adafruit/Adafruit-Mini-Sparkle-Motion-PCB/factory-reset/README.md

## Factory Reset file - Mini Sparkle Motion - WLED-friendly ESP32 NeoPixel LED Driver

This is the factory reset file for the Mini Sparkle Motion - WLED-friendly ESP32 NeoPixel LED Driver.
