adafruit/Adafruit-Mini-Sparkle-Motion-PCB/Adafruit Mini Sparkle Motion.brd

## EAGLE design Adafruit Mini Sparkle Motion.brd (2025-01-15)

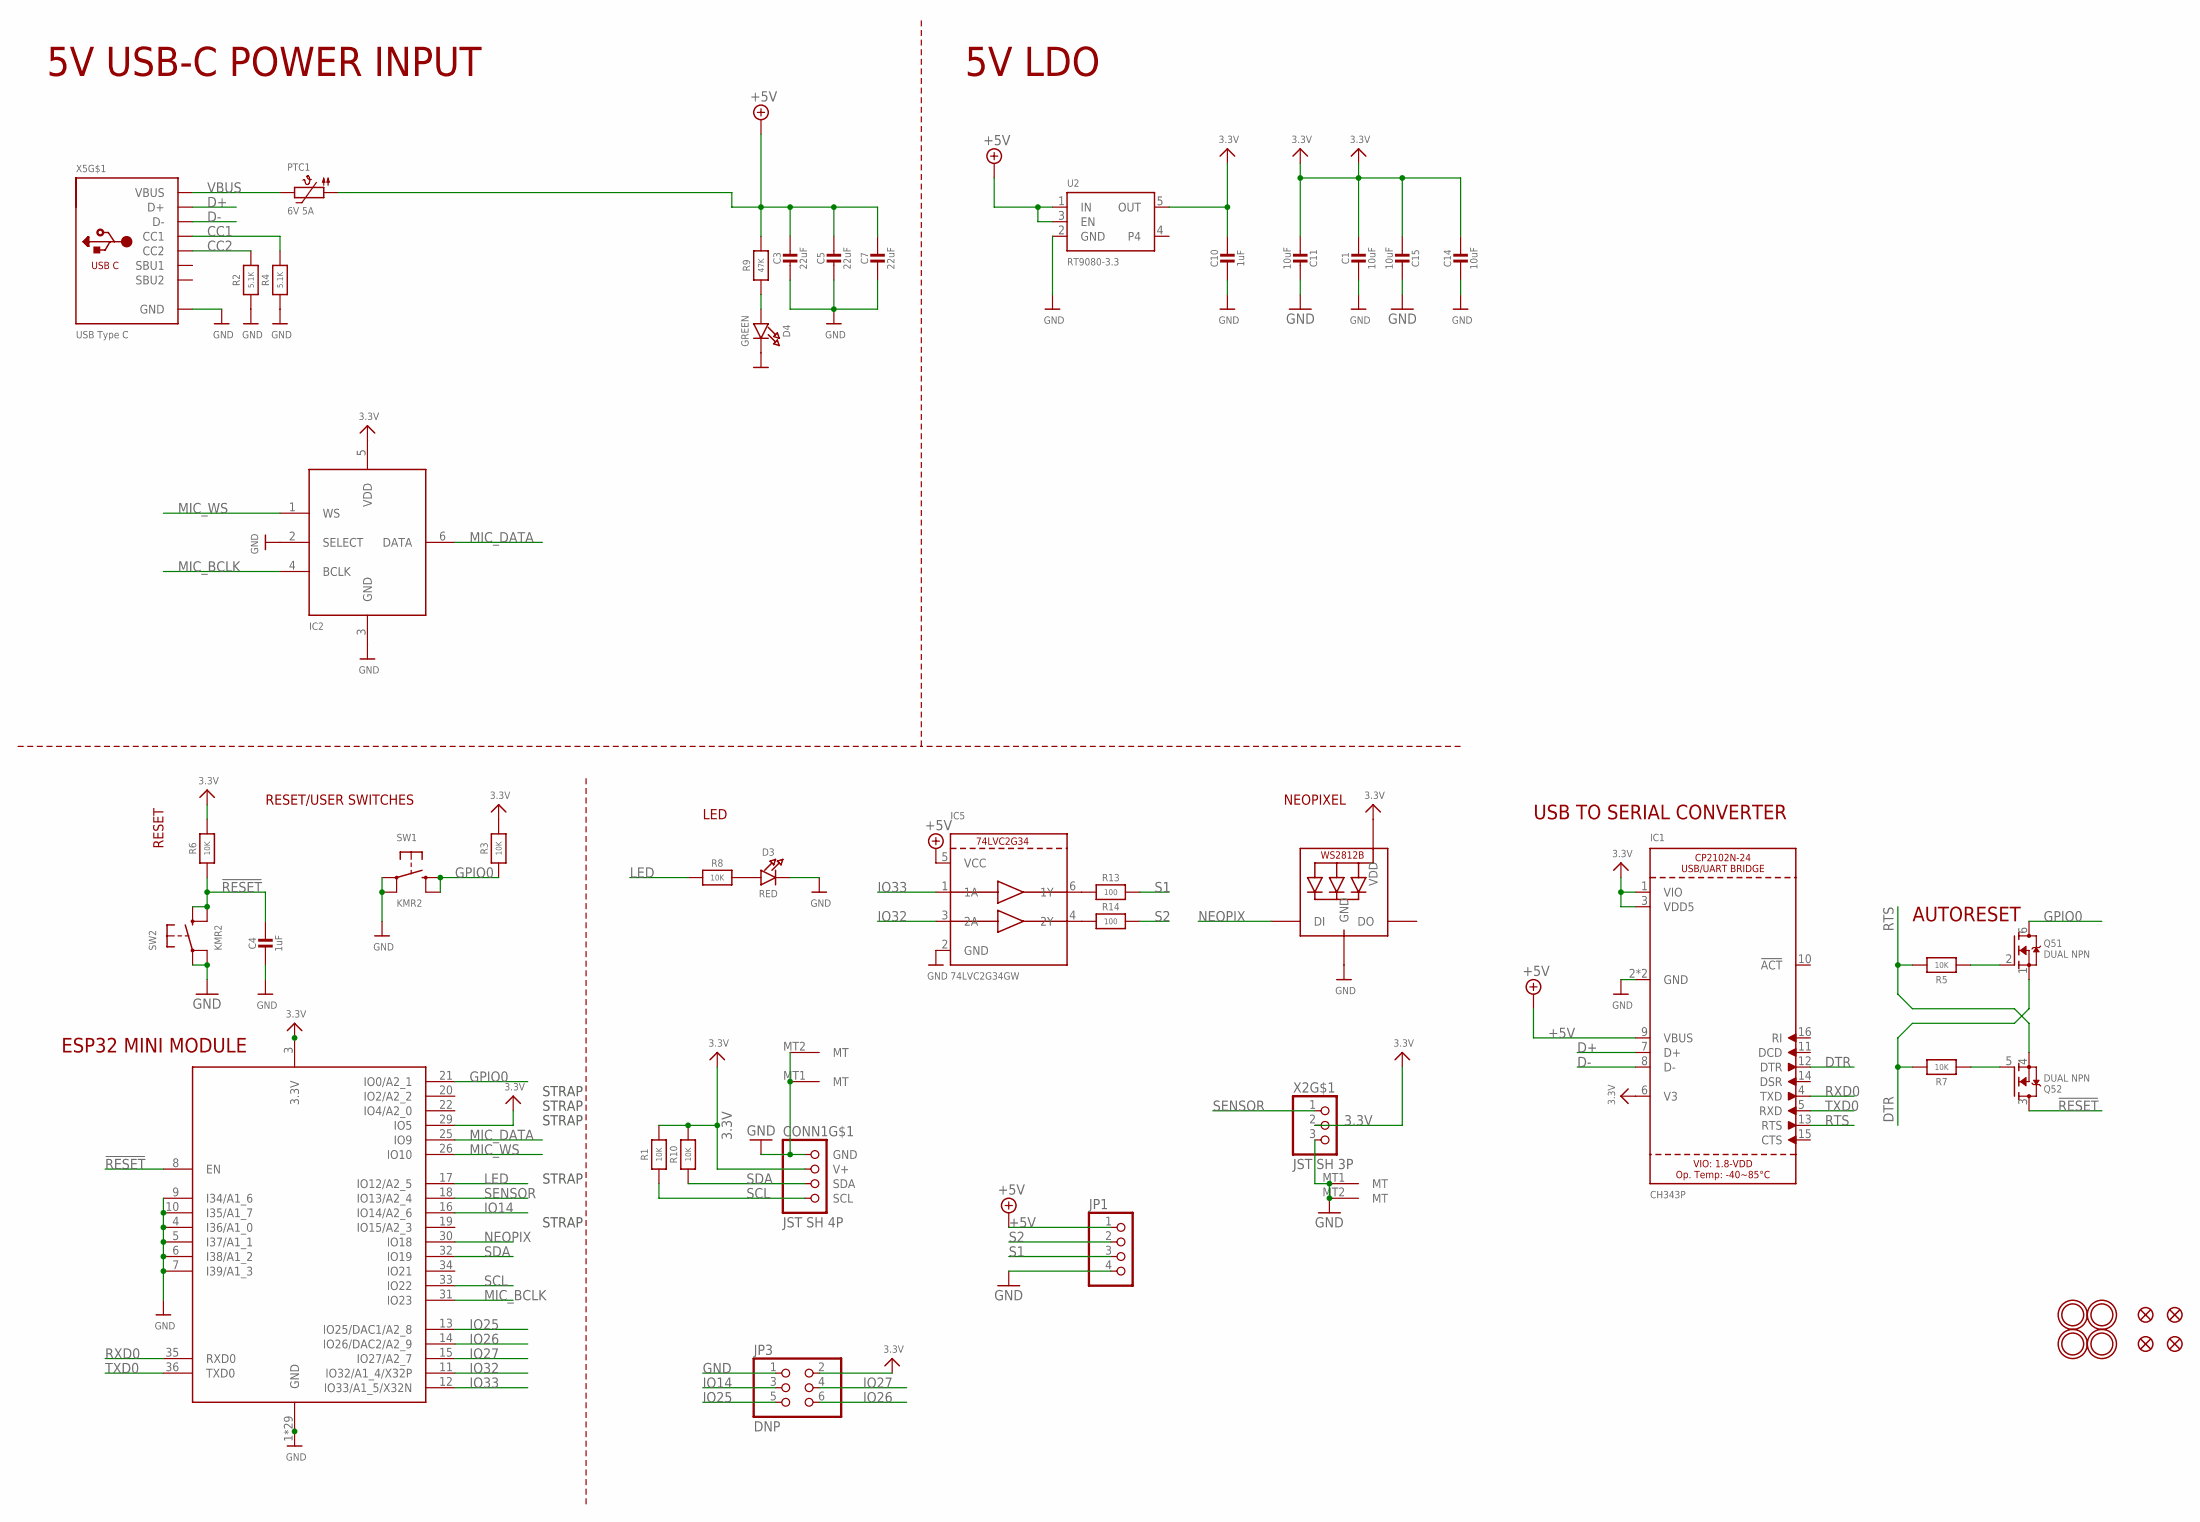
[picture p2: schematic Adafruit Mini Sparkle Motion.sch]

Parts:
C1, C11, C14, C15: 10uF; 0805-NO
C3, C5, C7: 22uF; 0805-NO
C4, C10: 1uF; _0402NO
CONN1: JST SH 4P; JST_SH4
D3: RED; CHIPLED_0603_NOOUTLINE
D4: GREEN; CHIPLED_0603_NOOUTLINE
IC1: CH343P; QFN16_3MM
IC2: ICS-43434; SPH0645LM4H
IC5: 74LVC2G34GW; SC70-6L
JP1: HEADER-1X4; 1X04_OVAL
JP3: DNP; 2X03_ROUND_70MIL
LED1: WS2812B_SK6805_1515; SK6805_1515
PTC1: 6V 5A; PTC1210
Q5: DUAL NPN; SOT363; JLC_ROTATION 90
R1, R3, R5, R6, R7, R8, R10: 10K; _0402NO
R2, R4: 5.1K; _0402NO
R9: 47K; _0402NO
R13, R14: 100; _0402NO
SW1, SW2: KMR2; BTN_RKB2_4.6X2.8
U2: RT9080-3.3; SOT23-5; JLC_ROTATION 0
U$14, U$20, U$28, U$31: MOUNTINGHOLE2.5; MOUNTINGHOLE_2.5_PLATED
U$23, U$25, U$34, U$35: FIDUCIAL_0.5MM
X2: JST SH 3P; JST_SH3
X4: ESP32-MINI-1
X5: USB Type C; USB_C_CUSB31-CFM2AX-01-X

Connections:
3.3V: C1.1, C10.1, C11.1, C14.1, C15.1, CONN1.2 (V+), IC1.1 (VIO), IC1.3 (VDD5), IC1.6 (V3), IC2.5 (VDD), JP3.2, LED1.2 (VDD), R1.2, R3.2, R6.2, R10.2, U2.5 (OUT), X2.2, X4.3 (3.3V), X4.29 (IO5)
!RESET: C4.1, Q5.3 (D), R6.1, SW2.B (S), SW2.B' (S1), X4.8 (EN)
+5V: C3.1, C5.1, C7.1, IC1.9 (VBUS), IC5.5 (VCC), JP1.1, PTC1.P$1 (1), R9.2, U2.1 (IN), U2.3 (EN)
CC1: R4.2, X5.A5 (CC1)
CC2: R2.2, X5.B5 (CC2)
D+: IC1.7 (D+), X5.A6 (D+), X5.B6 (D+)
D-: IC1.8 (D-), X5.A7 (D-), X5.B7 (D-)
DTR: IC1.12 (DTR), Q5.1 (S), R7.2
GND: C1.2, C3.2, C4.2, C5.2, C7.2, C10.2, C11.2, C14.2, C15.2, CONN1.1 (GND), CONN1.MT1 (MT), CONN1.MT2 (MT), D3.C, D4.C, IC1.2 (GND), IC1.THERMAL (GND), IC2.2 (SELECT), IC2.3 (GND), IC5.2 (GND), JP1.4, JP3.1, LED1.4 (GND), R2.1, R4.1, SW1.A, SW1.A' (P1), SW2.A, SW2.A' (P1), U2.2 (GND), X2.3, X2.MT1 (MT), X2.MT2 (MT), X4.1 (GND), X4.2 (GND), X4.4 (I36/A1_0), X4.5 (I37/A1_1), X4.6 (I38/A1_2), X4.7 (I39/A1_3), X4.9 (I34/A1_6), X4.10 (I35/A1_7), X4.27 (GND), X4.38 (GND), X4.39 (GND), X4.40 (GND), X4.41 (GND), X4.42 (GND), X4.43 (GND), X4.44 (GND), X4.45 (GND), X4.46 (GND), X4.47 (GND), X4.48 (GND), X4.49 (GND), X4.50 (GND), X4.51 (GND), X4.52 (GND), X4.53 (GND), X4.54 (GND), X4.55 (GND), X4.56 (GND), X4.57 (GND), X4.58 (GND), X4.59 (GND), X4.60 (GND), X4.61 (GND), X4.62 (GND), X4.63 (GND), X5.A1B12 (GND), X5.B1A12 (GND)
GPIO0: Q5.6 (D), R3.1, SW1.B (S), SW1.B' (S1), X4.21 (IO0/A2_1)
IO14: JP3.3, X4.16 (IO14/A2_6)
IO25: JP3.5, X4.13 (IO25/DAC1/A2_8)
IO26: JP3.6, X4.14 (IO26/DAC2/A2_9)
IO27: JP3.4, X4.15 (IO27/A2_7)
IO32: IC5.3 (2A), X4.11 (IO32/A1_4/X32P)
IO33: IC5.1 (1A), X4.12 (IO33/A1_5/X32N)
LED: R8.1, X4.17 (IO12/A2_5)
MIC_BCLK: IC2.4 (BCLK), X4.31 (IO23)
MIC_DATA: IC2.6 (DATA), X4.25 (IO9)
MIC_WS: IC2.1 (WS), X4.26 (IO10)
unnamed: D3.A, R8.2
unnamed: Q5.5 (G), R7.1
unnamed: Q5.2 (G), R5.1
unnamed: IC5.6 (1Y), R13.1
unnamed: IC5.4 (2Y), R14.1
unnamed: D4.A, R9.1
NEOPIX: LED1.1 (DI), X4.30 (IO18)
RTS: IC1.13 (RTS), Q5.4 (S), R5.2
RXD0: IC1.4 (TXD), X4.35 (RXD0)
S1: JP1.3, R13.2
S2: JP1.2, R14.2
SCL: CONN1.4 (SCL), R1.1, X4.33 (IO22)
SDA: CONN1.3 (SDA), R10.1, X4.32 (IO19)
SENSOR: X2.1, X4.18 (IO13/A2_4)
TXD0: IC1.5 (RXD), X4.36 (TXD0)
VBUS: PTC1.P$2 (2), X5.A4B9 (VBUS), X5.B4A9 (VBUS)

Notes on the sheet:
5V USB-C POWER INPUT
RESET
LED
NEOPIXEL
ESP32 MINI MODULE
RESET/USER SWITCHES
AUTORESET
USB TO SERIAL CONVERTER
5V LDO
STRAP

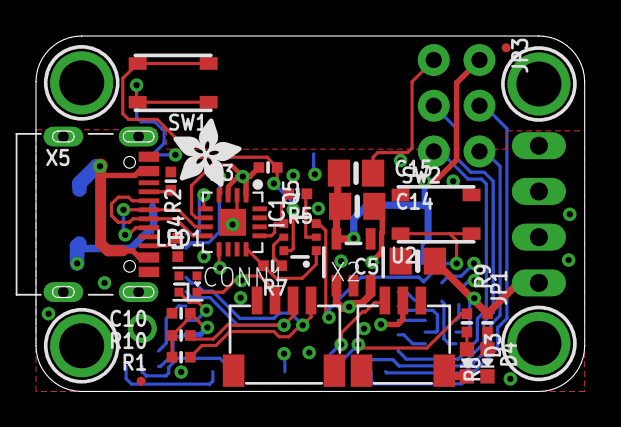
[picture p3: board Adafruit Mini Sparkle Motion.brd from above]

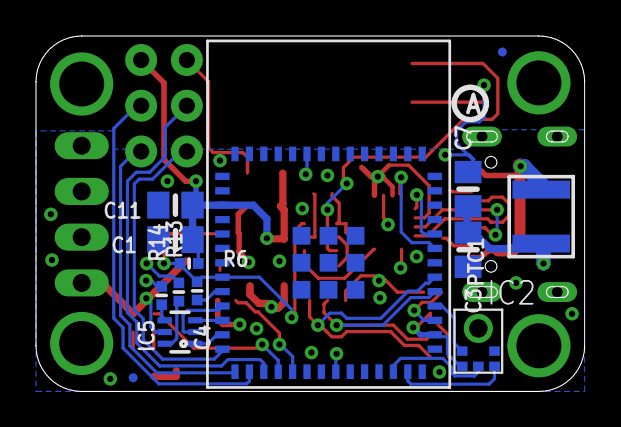
[picture p4: board Adafruit Mini Sparkle Motion.brd from below]

Board: 4 copper layers, 30.5 x 19.7 mm, 68 parts (22 on the bottom side), 36 nets.

Other parts of the board:
PLABEL0: PLABEL0
PLABEL1: PLABEL1
PLABEL2: PLABEL2
PLABEL3: PLABEL3
PLABEL4: PLABEL4
PLABEL5: PLABEL5
PLABEL6: PLABEL6
PLABEL7: PLABEL7
PLABEL8: PLABEL8
PLABEL9: PLABEL9
PLABEL10: PLABEL10
PLABEL11: PLABEL11
PLABEL15: PLABEL15
PLABEL16: PLABEL16
PLABEL17: PLABEL17
PLABEL18: PLABEL18
PLABEL20: PLABEL20
PLABEL21: PLABEL21
PLABEL22: PLABEL22
PLABEL23: PLABEL23
U$27: ADAFRUIT_3.5MM
U$29: PCBFEAT-REV-040
